bt-soft/nano-wallscout-2/doc/gate_csomag-2.png

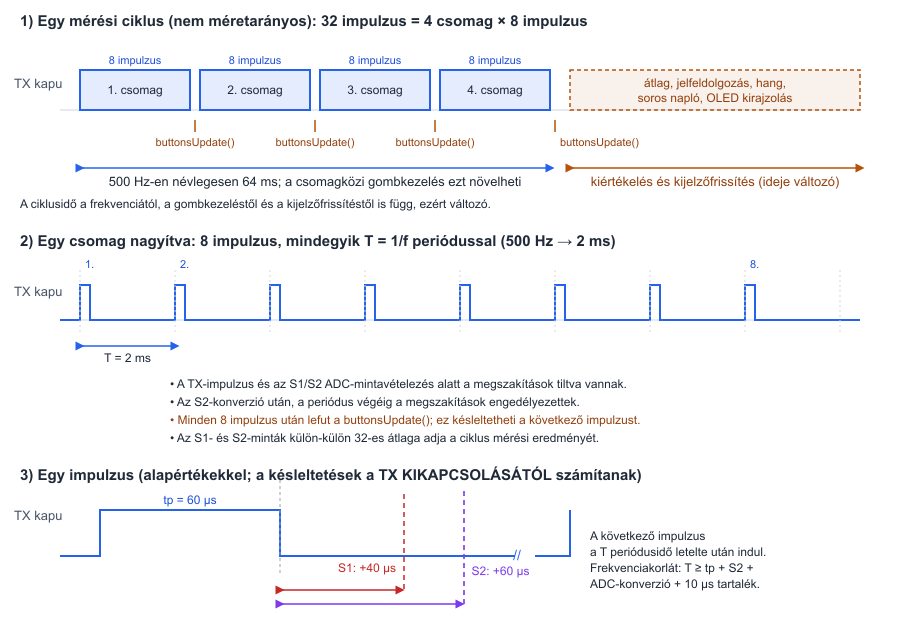
doc/gate_csomag-2.png
