bt-soft/nano-wallscout-2/doc/meres_idodiagram-2.png

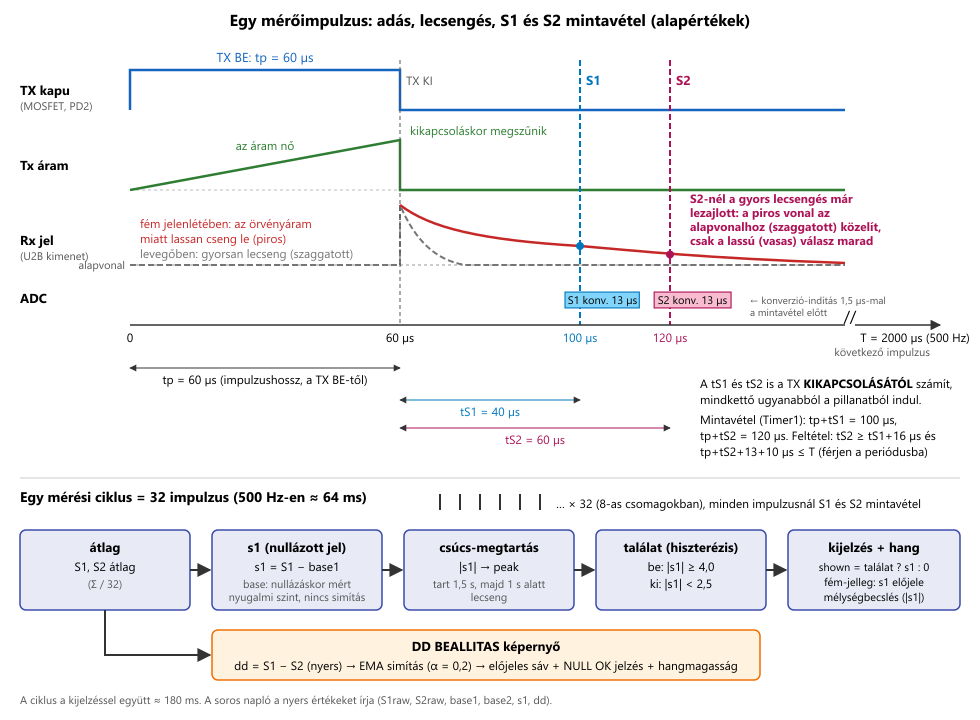
doc/meres_idodiagram-2.png
