bt-soft/nano-wallscout-2/doc/pi-lecsengés-S1-S2-v2.png

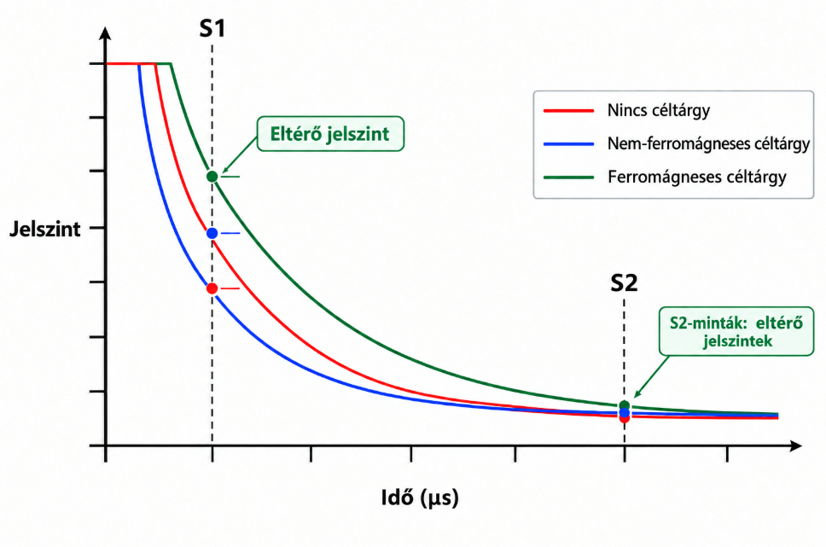
doc/pi-lecsengés-S1-S2-v2.png
