bt-soft/nano-wallscout-2/doc/rx_szkop.png

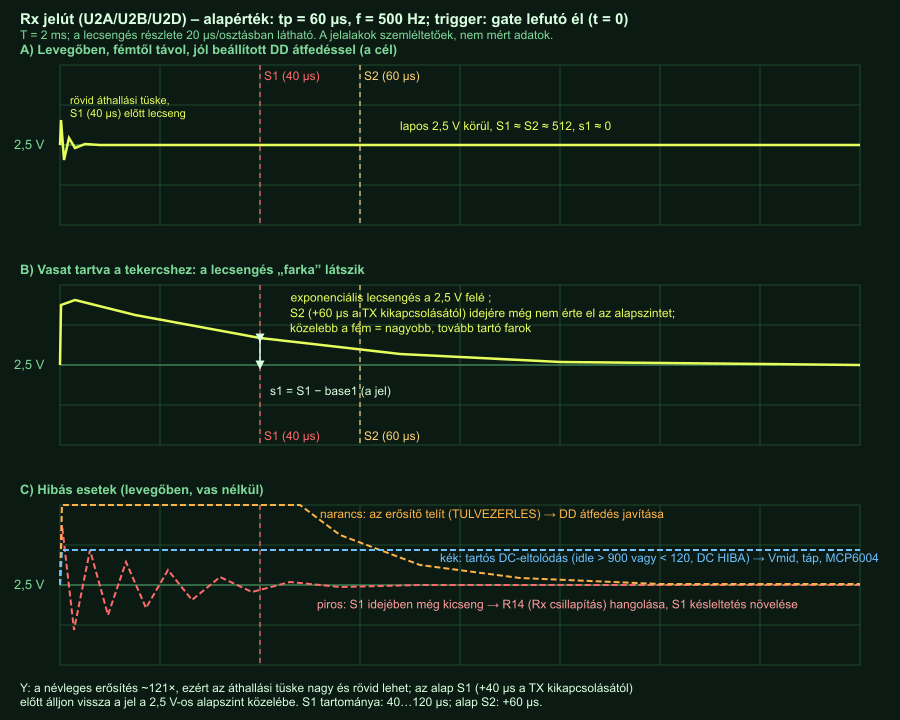
doc/rx_szkop.png
