bt-soft/nano-wallscout-2/kicad/nano-wallscout-Nano/nano-wallscout.kicad_pcb

## KiCad design kicad/nano-wallscout-Nano/nano-wallscout.kicad_pcb (2026-11-07)

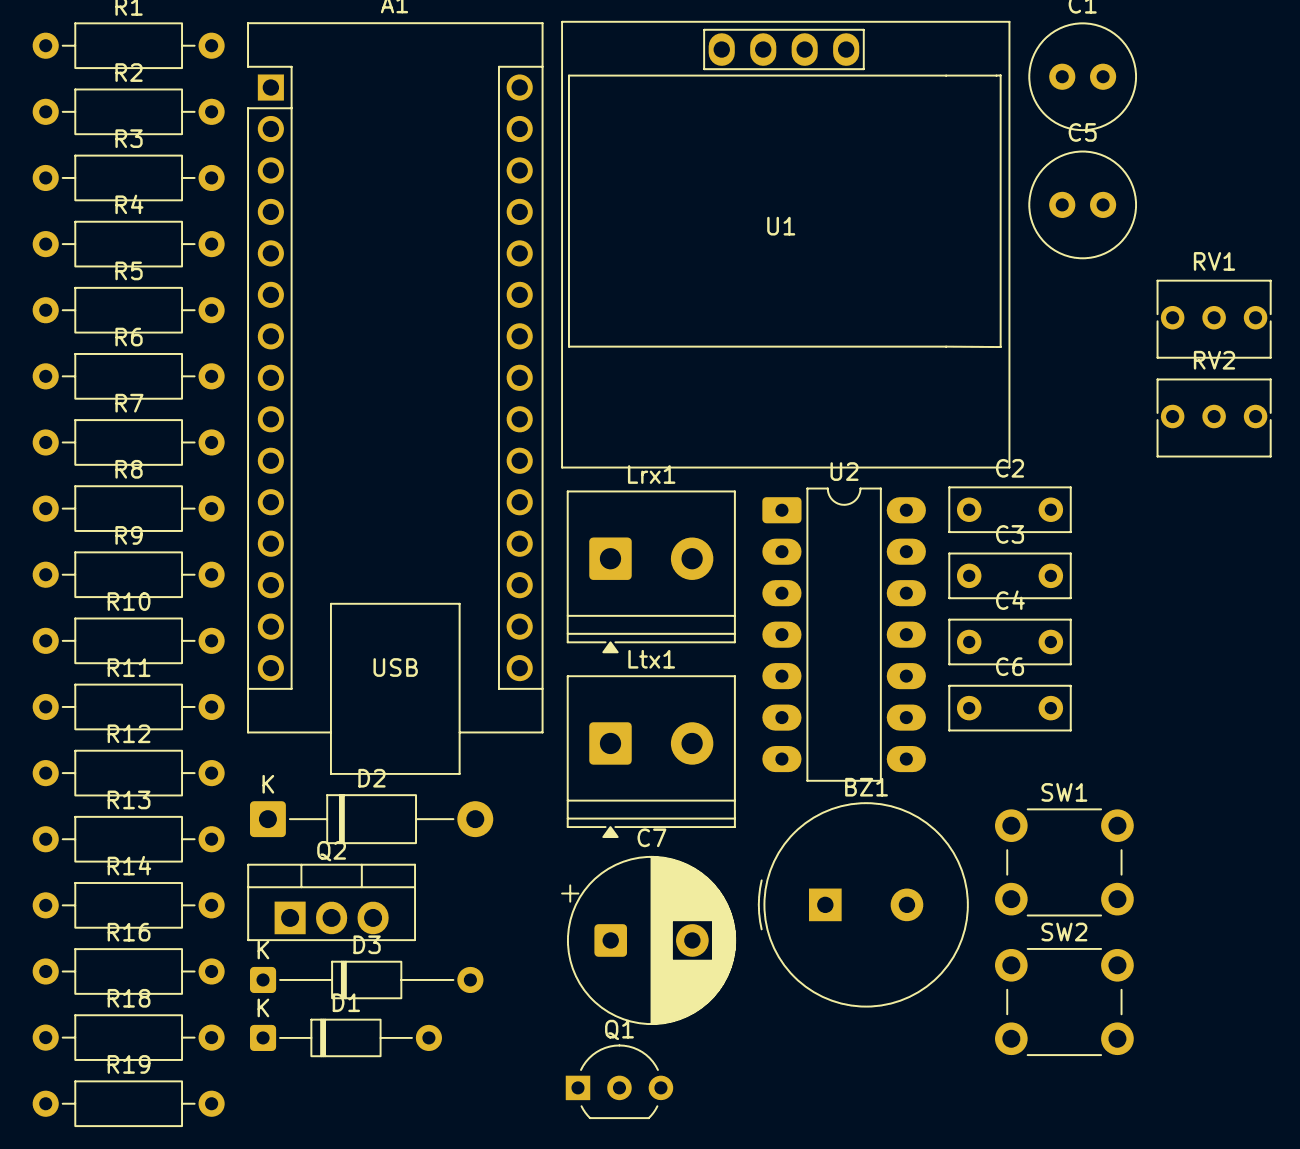
[picture p8: board nano-wallscout.kicad_pcb from above]

Board: 2 copper layers, 39 parts (0 on the bottom side), 29 nets, no tracks yet.

Parts:
A1: Arduino_Nano_v2.x; Arduino_Nano
BZ1: Buzzer; Buzzer_TDK_PS1240P02BT_D12.2mm_H6.5mm
C1: 100uF/25v; C_Radial_D6.3mm_H11.0mm_P2.50mm
C2, C3, C4, C6: 100nF; C_Rect_L7.2mm_W2.5mm_P5.00mm
C5: 10uF; C_Radial_D6.3mm_H11.0mm_P2.50mm
C7: 1000uF/16V; CP_Radial_D10.0mm_P5.00mm
D1: 1N4148; D_DO-35_SOD27_P10.16mm_Horizontal
D2: UF4007; D_DO-41_SOD81_P12.70mm_Horizontal
D3: ZPY36 / 1W; D_DO-35_SOD27_P12.70mm_Horizontal
Lrx1: 1mH; TerminalBlock_Phoenix_PT-1,5-2-5.0-H_1x02_P5.00mm_Horizontal
Ltx1: 1mH; TerminalBlock_Phoenix_PT-1,5-2-5.0-H_1x02_P5.00mm_Horizontal
Q1: 2N2222; TO-92_Inline_Wide
Q2: IRLZ44N; TO-220-3_Vertical
R1: 150; R_Axial_DIN0207_L6.3mm_D2.5mm_P10.16mm_Horizontal
R2, R10, R14, R16: 1k; R_Axial_DIN0207_L6.3mm_D2.5mm_P10.16mm_Horizontal
R3, R6, R7, R8, R11: 100k; R_Axial_DIN0207_L6.3mm_D2.5mm_P10.16mm_Horizontal
R4: 33k; R_Axial_DIN0207_L6.3mm_D2.5mm_P10.16mm_Horizontal
R5: 390; R_Axial_DIN0207_L6.3mm_D2.5mm_P10.16mm_Horizontal
R9, R12, R13, R19: 10k; R_Axial_DIN0207_L6.3mm_D2.5mm_P10.16mm_Horizontal
R18: 100; R_Axial_DIN0207_L6.3mm_D2.5mm_P10.16mm_Horizontal
RV1: 2k; Potentiometer_Bourns_3266Y_Vertical
RV2: 5k; Potentiometer_Bourns_3266Y_Vertical
SW1: Kalibrálás; SW_PUSH_6mm_H8mm
SW2: Nullázás; SW_PUSH_6mm_H8mm
U1: SSD1306; 128x64OLED
U2: MCP6004; DIP-14_W7.62mm_LongPads

Connections:
+5V: A1.27 (+5V), C6.2, C7.1, R1.2, R6.2, U1.2 (VCC), U2.4 (V+)
+BATT: A1.30 (VIN), C1.1, C2.2, Ltx1.1, R3.2, R16.2
GND: A1.4 (GND), A1.29 (GND), C1.2, C2.1, C3.1, C4.2, C5.2, C6.1, C7.2, D3.2 (A), Q1.3 (E), Q2.3 (S), R4.1, R7.1, R19.1, SW1.1, SW2.1, U1.1 (GND), U2.11 (V-)
unnamed: A1.19 (A0), R5.1
unnamed: A1.20 (A1), C4.1, R3.1, R4.2
unnamed: A1.23 (A4), U1.4 (SDA)
unnamed: A1.24 (A5), U1.3 (SCL)
unnamed: A1.5 (D2), R18.2
unnamed: A1.7 (D4), SW1.2
unnamed: A1.8 (D5), SW2.2
unnamed: A1.14 (D11), R2.1
unnamed: BZ1.1 (+), D1.1 (K), R1.1
unnamed: BZ1.2 (-), D1.2 (A), Q1.1 (C)
unnamed: D2.2 (A), Ltx1.2, Q2.2 (D), RV2.2, RV2.3
unnamed: D2.1 (K), D3.1 (K)
unnamed: Lrx1.1, R13.1, R14.2
unnamed: Q1.2 (B), R2.2
unnamed: Q2.1 (G), R18.1, R19.2
unnamed: R10.2, R11.1, U2.1
unnamed: R14.1, RV1.1
unnamed: R16.1, RV2.1
unnamed: R13.2, U2.3 (+)
unnamed: R11.2, R12.2, U2.2 (-)
unnamed: R10.1, U2.5 (+)
unnamed: R8.2, R9.2, U2.6 (-)
unnamed: C3.2, C5.1, R6.1, R7.2, U2.10 (+)
unnamed: Lrx1.2, R9.1, R12.1, RV1.2, RV1.3, U2.8, U2.9 (-)
unnamed: R8.1, U2.7, U2.12 (+)
unnamed: R5.2, U2.13 (-), U2.14
