bt-soft/nano-wallscout-2/(commit log)

2026-11-07 Add KiCad project files and update .gitignore
2026-11-12 Update docs
    [nano-wallscout-Atmega328P.kicad_pcb, nano-wallscout-Atmega328P.kicad_sch, nano-wallscout.kicad_sch]
